kristiangoystdal/Design-av-Integrerte-Kretser---Prosjekt/main.tex

\documentclass{article}
\usepackage{graphicx} % Required for inserting images
\usepackage{svg} % Makes it possible to include svg-images
\usepackage{cite}
\usepackage[a4paper, total={6in, 8in}]{geometry}
\usepackage{float}
\usepackage{makecell}
\usepackage{colortbl}
\usepackage{listings}
\usepackage[colorlinks=true,allcolors=black]{hyperref}
\usepackage[british]{babel}     % Defining UK English as language. This will among other things ensure that dates are displayed as 24/03/1997 rather than 03/24/1997 in the bibliography.
\addto\extrasbritish{   % Change naming of different functions, e.g. figure references.
    \renewcommand*\contentsname{Table of Contents}  % Rename table of contents
    \renewcommand{\listfigurename}{List of Figures} % Rename list of figures
    \renewcommand{\listtablename}{List of Tables}   % Rename list of tables
    \def\equationautorefname{Equation}              % Autoref-name for equations
    \def\figureautorefname{Figure}                  % Autoref-name for figures
    \def\tableautorefname{Table}                    % Autoref-name for tables
    \def\sectionautorefname{Section}                % Autoref-name for sections
    \def\subsectionautorefname{Subsection} % Autoref-name for subsections
    \def\subsubsectionautorefname{Subsection} % Autoref-name for subsubsections
    \def\appendixautorefname{Appendix}
}

\usepackage{appendix}
\usepackage{lipsum}
\usepackage{geometry}

% begin appendix autoref patch [\autoref subsections in appendix](https://tex.stackexchange.com/questions/149807/autoref-subsections-in-appendix)
\usepackage{etoolbox}
\makeatletter
\patchcmd{\hyper@makecurrent}{%
    \ifx\Hy@param\Hy@chapterstring
        \let\Hy@param\Hy@chapapp
    \fi
}{%
    \iftoggle{inappendix}{%true-branch
        % list the names of all sectioning counters here
        \@checkappendixparam{chapter}%
        \@checkappendixparam{section}%
        \@checkappendixparam{subsection}%
        \@checkappendixparam{subsubsection}%
        \@checkappendixparam{paragraph}%
        \@checkappendixparam{subparagraph}%
    }{}%
}{}{\errmessage{failed to patch}}

\newcommand*{\@checkappendixparam}[1]{%
    \def\@checkappendixparamtmp{#1}%
    \ifx\Hy@param\@checkappendixparamtmp
        \let\Hy@param\Hy@appendixstring
    \fi
}
\makeatletter

\newtoggle{inappendix}
\togglefalse{inappendix}

\apptocmd{\appendix}{\toggletrue{inappendix}}{}{\errmessage{failed to patch}}
\apptocmd{\subappendices}{\toggletrue{inappendix}}{}{\errmessage{failed to patch}}
% end appendix autoref patch

\lstdefinestyle{aimspiceStyle}{
    language=Verilog,
    basicstyle=\small\ttfamily,
    commentstyle=\color{red}, % Adjust the color as needed
    morecomment=[l]{*}, % Define '*' as the comment character
    keywordstyle=,
    numberstyle=\tiny\color{gray},
    numbers=left,
    numbersep=5pt,
    breaklines=true,
    frame=lines,
    backgroundcolor=\color{lightgray!20},
}

\definecolor{codegreen}{rgb}{0,0.6,0}
\definecolor{codegray}{rgb}{0.5,0.5,0.5}
\definecolor{codepurple}{rgb}{0.58,0,0.82}
\definecolor{backcolour}{rgb}{0.95,0.95,0.92}

\lstdefinestyle{outputstyle}{
    language=Verilog,
    backgroundcolor=\color{backcolour},
    commentstyle=\color{codegreen},
    keywordstyle=\color{black},
    numberstyle=\tiny\color{codegray},
    stringstyle=\color{codepurple},
    basicstyle=\footnotesize\ttfamily,
    breakatwhitespace=false,
    breaklines=true,
    captionpos=b,
    frame=single, % Add this line to draw a frame around the code
    numbers=none, % Set this to none to disable line numbering
    keepspaces=true,
    showspaces=false,
    showstringspaces=false,
    showtabs=false,
    tabsize=2
}

\lstset{style=outputstyle}

\lstdefinestyle{verilogStyle}{
    language=Verilog,     % Set the language to Verilog
    basicstyle=\small\ttfamily,
    commentstyle=\color{red},
    keywordstyle=\color{blue},
    numberstyle=\tiny\color{gray},
    numbers=left,
    numbersep=5pt,
    breaklines=true,
    frame=lines,
    backgroundcolor=\color{lightgray!20}, % Lighter background color
}
\usepackage{titlesec}

\setcounter{secnumdepth}{4}
\titleformat{\paragraph}
{\normalfont\normalsize\bfseries}{\theparagraph}{1em}{}
\titlespacing*{\paragraph}
{0pt}{3.25ex plus 1ex minus .2ex}{1.5ex plus .2ex}

\newcommand{\HRule}{\rule{\linewidth}{0.5mm}}

\begin{document}

\begin{titlepage}
\vbox{ }
\vbox{ }
\begin{center}
% Upper part of the page
\includesvg[width=\textwidth]{Figures/logo.svg}\\[1cm]
\textsc{\LARGE TFE4152 Design of Integrated Circuits}\\[1cm]
\textsc{\Large Term project fall 2023}\\[0.5cm]
\vbox{ }

% Title
\HRule \\[0.4cm]
{ \huge \bfseries Design \& Test of a \\Multiply-Accumulate unit}\\[0.4cm] %TODO: replace "TITLE" with some project title, e.g. "Design of a Multiply Accumulate Unit"
\HRule \\[1.5cm]

% Author
\large
\emph{Authors:}\\
Einar Bergslid \& Kristian Gøystdal %TODO: Replace this line with your names
\vfill

\end{center}
\end{titlepage}

\newpage
\setlength{\parskip}{0ex}
\renewcommand{\baselinestretch}{0.1}\normalsize
\tableofcontents
\renewcommand{\baselinestretch}{1.00}\normalsize
\setlength{\parskip}{2ex}
\rule{\textwidth}{1pt}
\newpage

\input{Text/Introduction}
\input{Text/Theory}
\input{Text/Method}
\input{Text/Results}
\input{Text/Discussion}
\input{Text/Conclusion}

\newpage
\addcontentsline{toc}{section}{References}
\bibliographystyle{unsrt}
\bibliography{bibliography}

\newpage
\vspace*{7 cm}
\begin{center}
\textbf{\Huge Appendices}
\end{center}
\addcontentsline{toc}{section}{Appendices}
\include{Text/appendix.tex}
\end{document}
