kristiangoystdal/Design-av-Integrerte-Kretser---Prosjekt/Figures/1-bit register.png

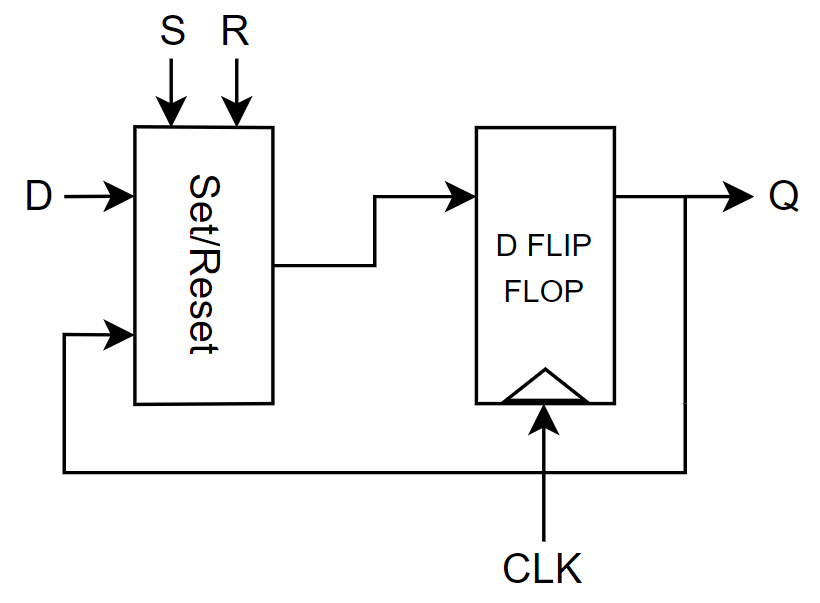
Figures/1-bit register.png
