kristiangoystdal/Design-av-Integrerte-Kretser---Prosjekt/Figures/8bitadder.png

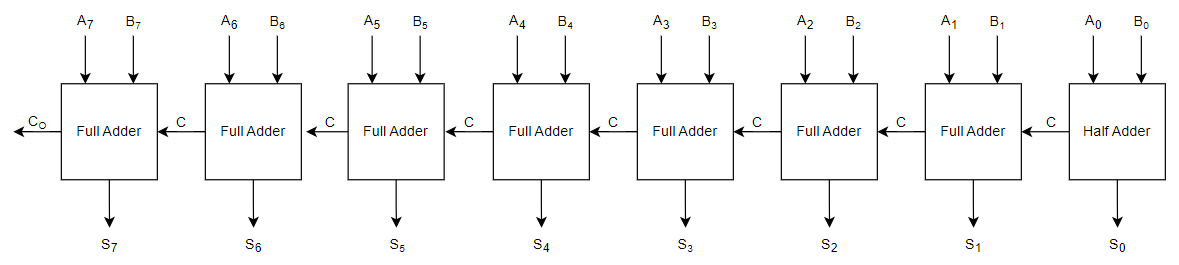
Figures/8bitadder.png
