kristiangoystdal/Design-av-Integrerte-Kretser---Prosjekt/Figures/8bitRegister.png

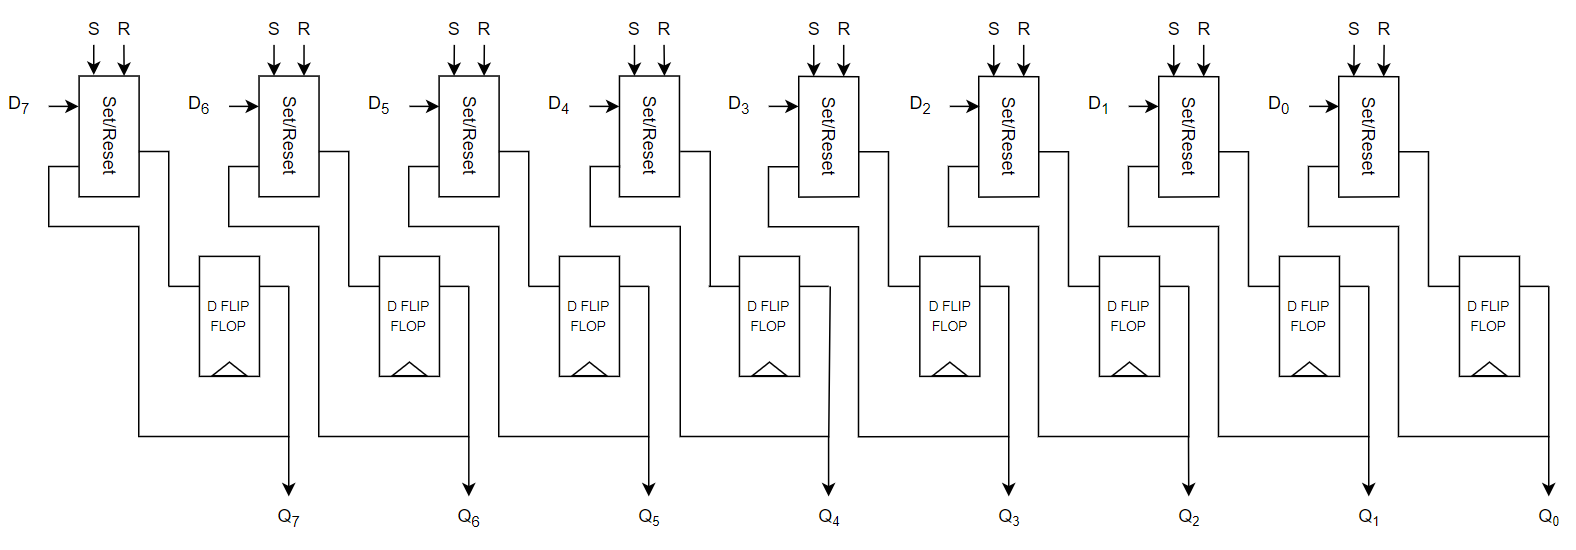
Figures/8bitRegister.png
