kristiangoystdal/Design-av-Integrerte-Kretser---Prosjekt/Figures/Aimspice_Plots/CornerFF.png

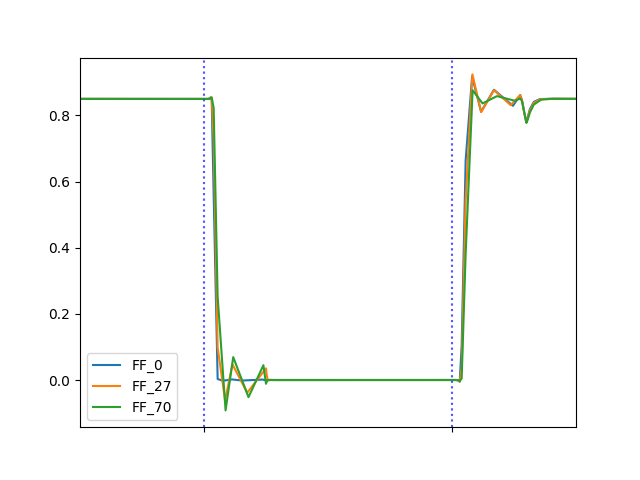
Figures/Aimspice_Plots/CornerFF.png
