kristiangoystdal/Design-av-Integrerte-Kretser---Prosjekt/Figures/Aimspice_Plots/FF_0.png

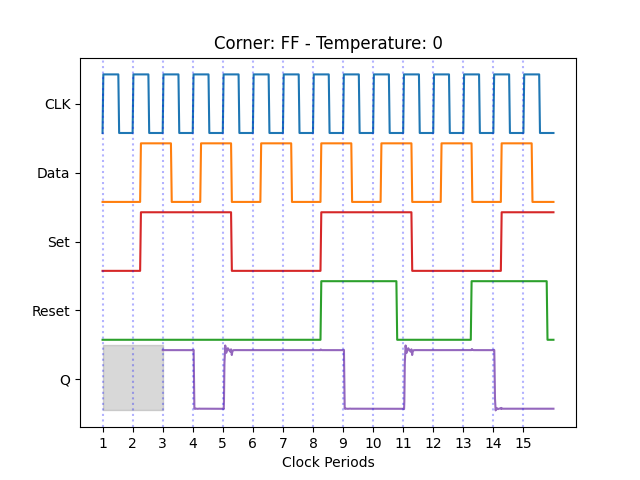
Figures/Aimspice_Plots/FF_0.png
