kristiangoystdal/Design-av-Integrerte-Kretser---Prosjekt/Figures/Aimspice_Plots/FF_27.png

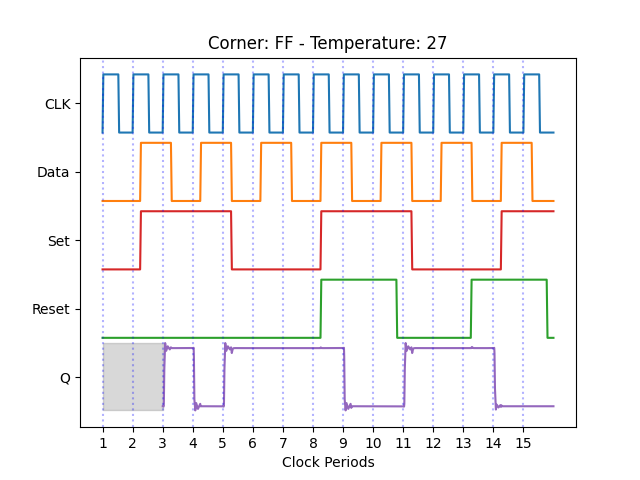
Figures/Aimspice_Plots/FF_27.png
