kristiangoystdal/Design-av-Integrerte-Kretser---Prosjekt/Figures/Aimspice_Plots/FS_27.png

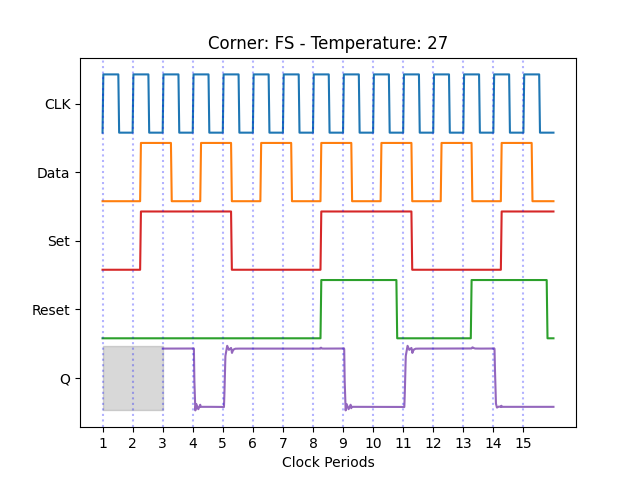
Figures/Aimspice_Plots/FS_27.png
