kristiangoystdal/Design-av-Integrerte-Kretser---Prosjekt/Figures/Aimspice_Plots/Temperatur70.png

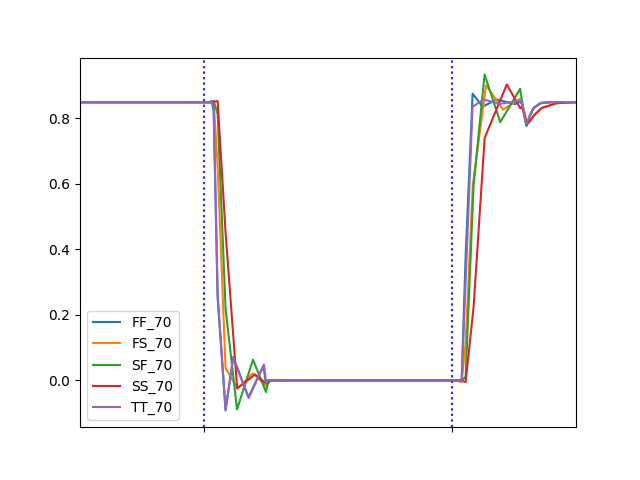
Figures/Aimspice_Plots/Temperatur70.png
