kristiangoystdal/Design-av-Integrerte-Kretser---Prosjekt/Figures/And gate.png

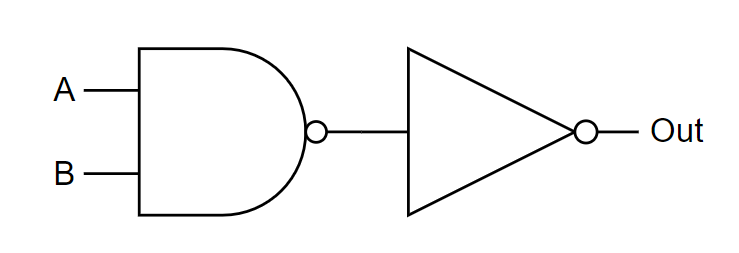
Figures/And gate.png
