kristiangoystdal/Design-av-Integrerte-Kretser---Prosjekt/Figures/Blokk.png

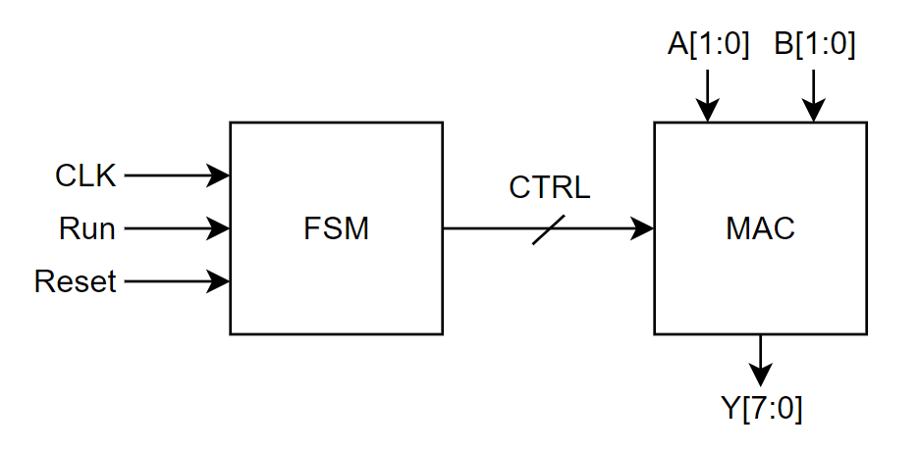
Figures/Blokk.png
