kristiangoystdal/Design-av-Integrerte-Kretser---Prosjekt/Figures/CornersTheory.png

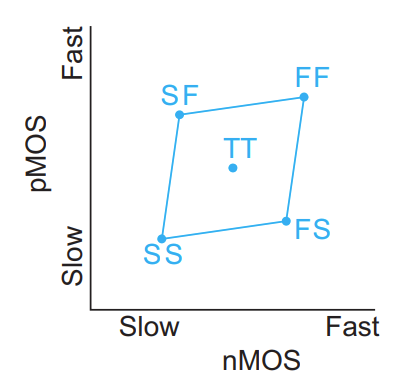
Figures/CornersTheory.png
