kristiangoystdal/Design-av-Integrerte-Kretser---Prosjekt/Figures/Current_VDD_FF.png

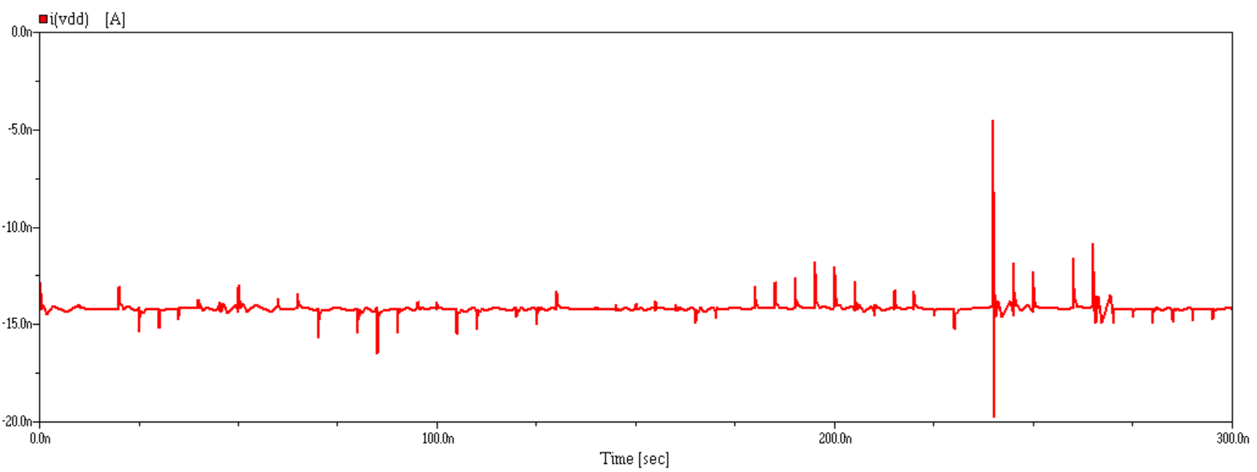
Figures/Current_VDD_FF.png
