kristiangoystdal/Design-av-Integrerte-Kretser---Prosjekt/Figures/Current_VDD_TT.png

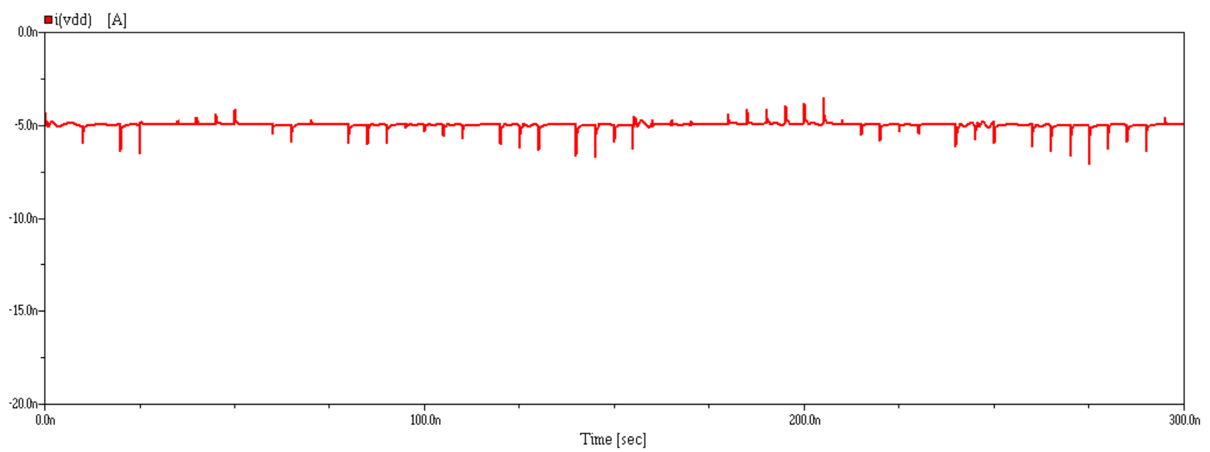
Figures/Current_VDD_TT.png
