kristiangoystdal/Design-av-Integrerte-Kretser---Prosjekt/Figures/D_Flip_Flop.png

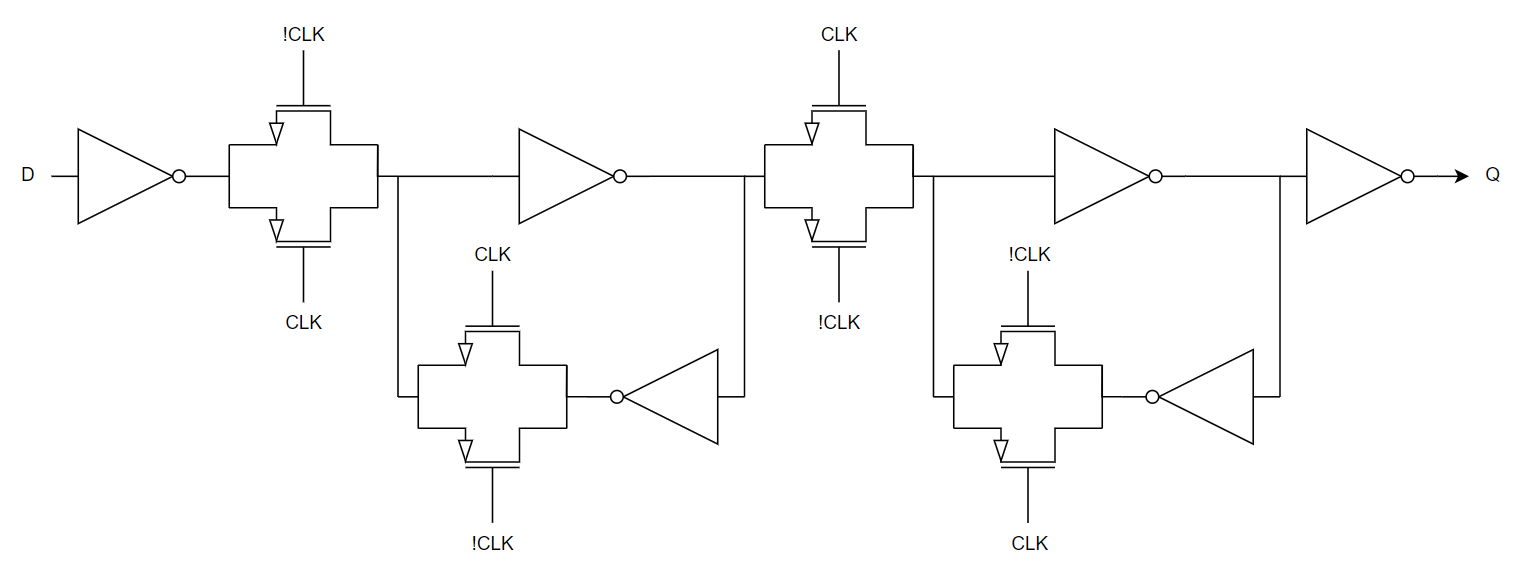
Figures/D_Flip_Flop.png
