kristiangoystdal/Design-av-Integrerte-Kretser---Prosjekt/Figures/DFF_Block.png

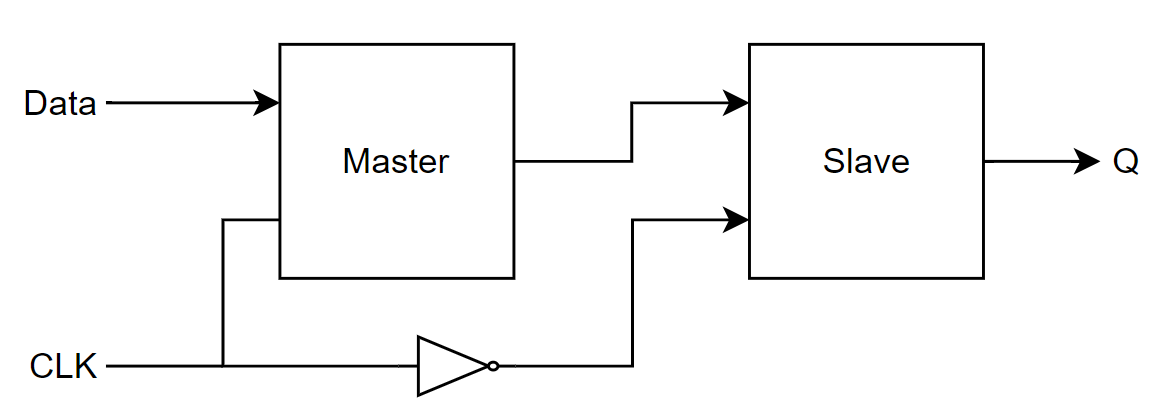
Figures/DFF_Block.png
