kristiangoystdal/Design-av-Integrerte-Kretser---Prosjekt/Figures/FSM LOGIC.drawio.png

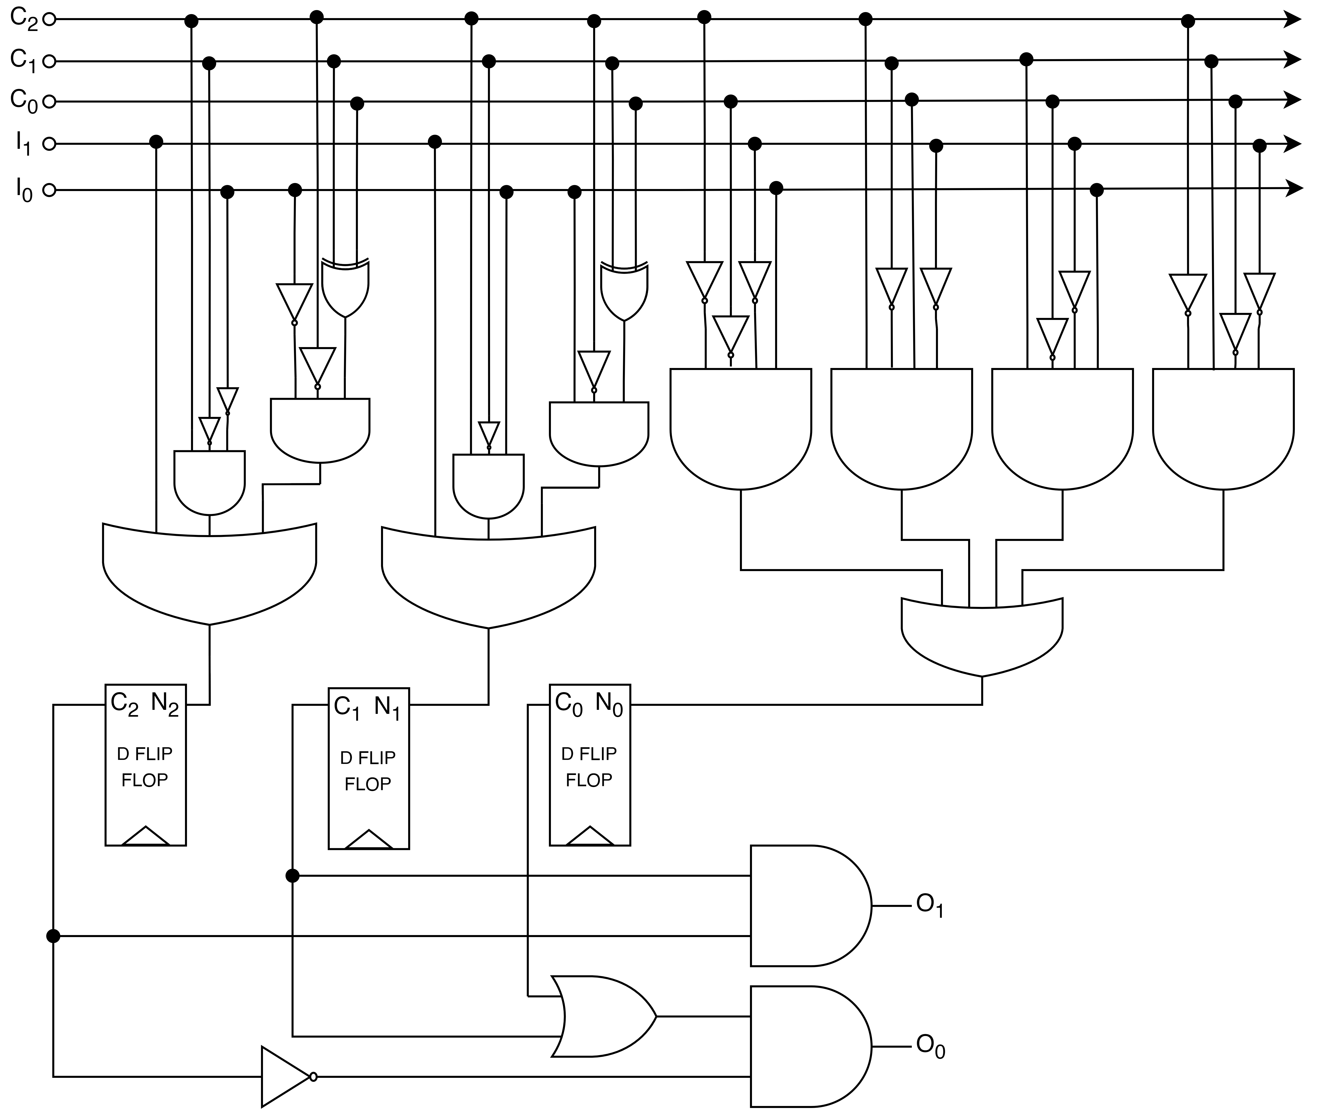
Figures/FSM LOGIC.drawio.png
