kristiangoystdal/Design-av-Integrerte-Kretser---Prosjekt/Figures/FSM-diagram.png

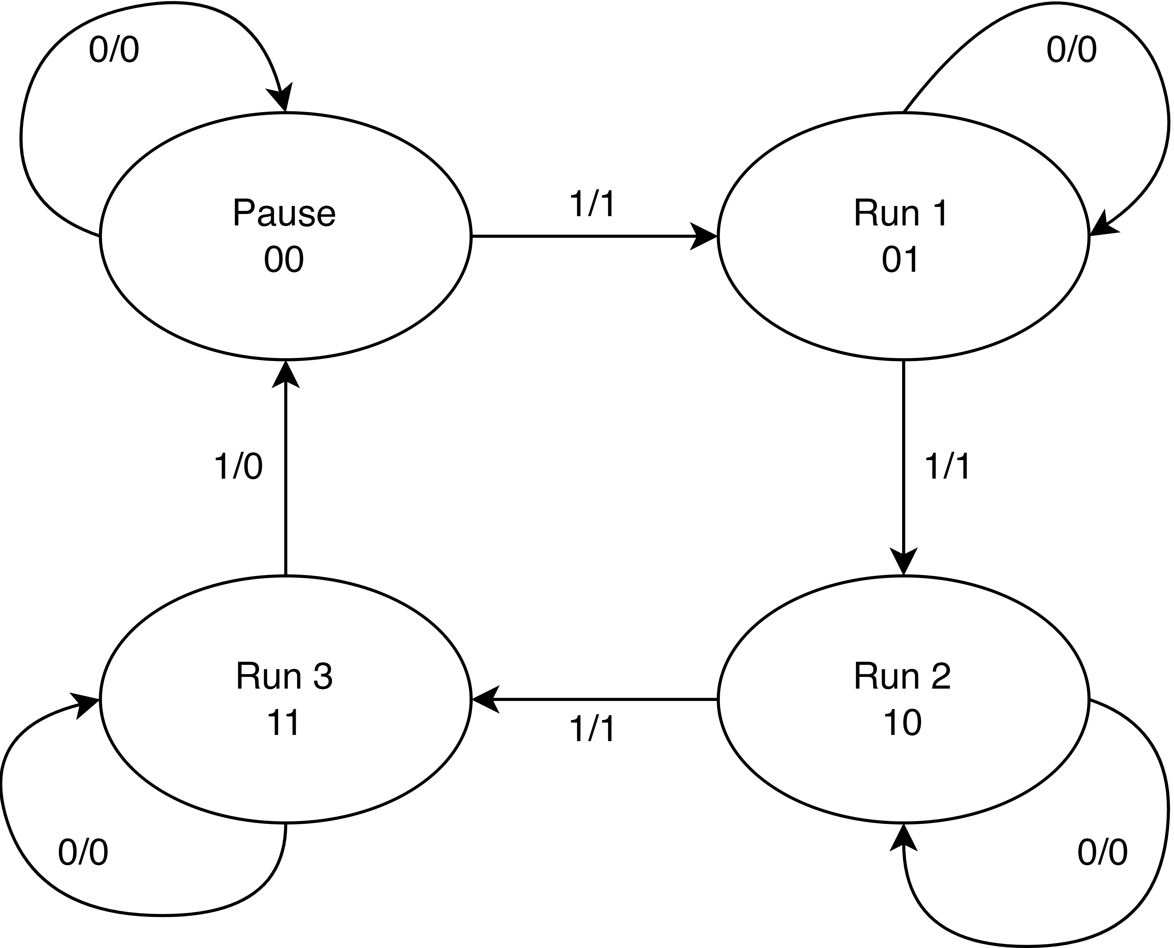
Figures/FSM-diagram.png
