kristiangoystdal/Design-av-Integrerte-Kretser---Prosjekt/Figures/FSM_overordnet.drawio.png

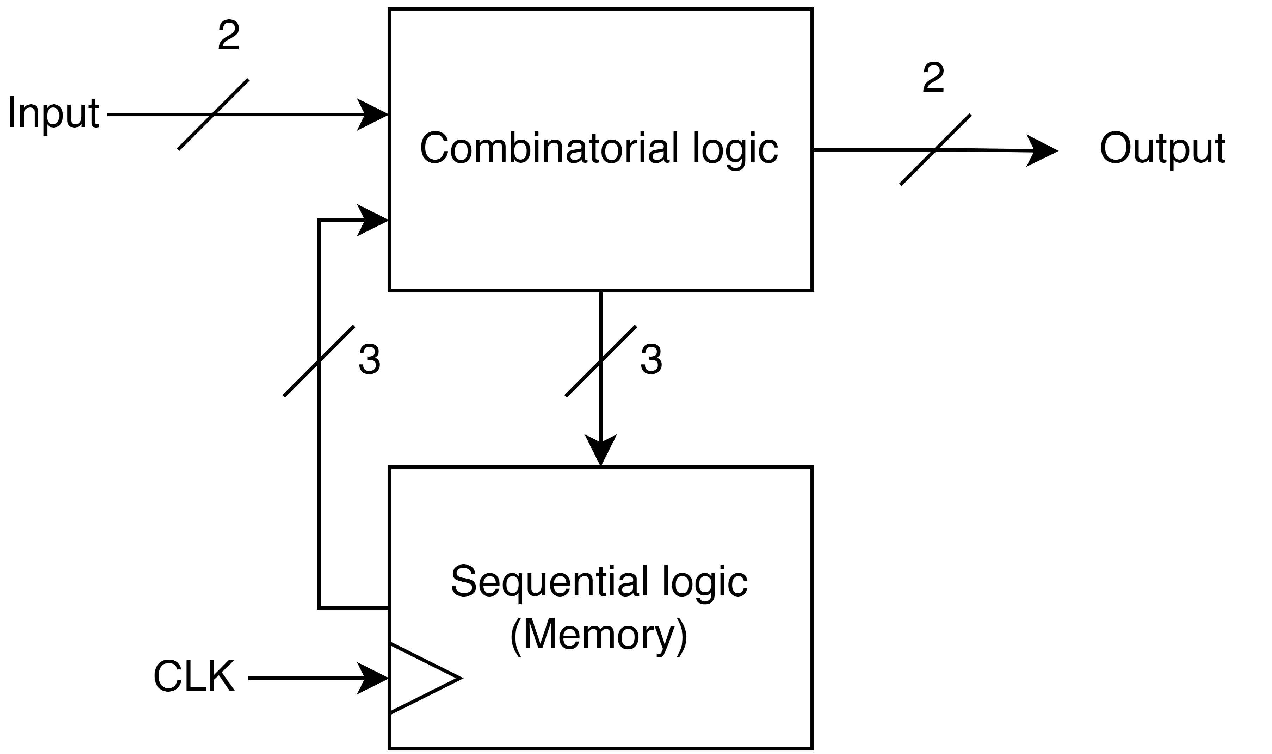
Figures/FSM_overordnet.drawio.png
