kristiangoystdal/Design-av-Integrerte-Kretser---Prosjekt/Figures/fulladder.png

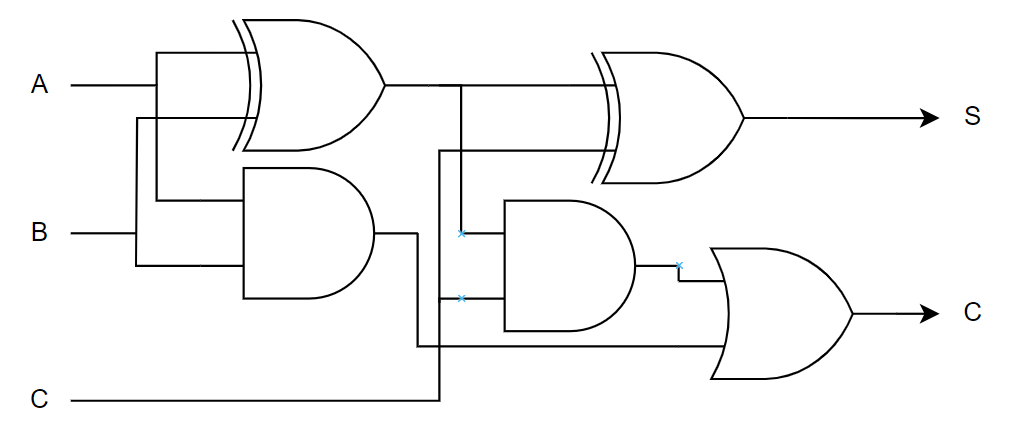
Figures/fulladder.png
