kristiangoystdal/Design-av-Integrerte-Kretser---Prosjekt/Figures/general fsm diagrams.png

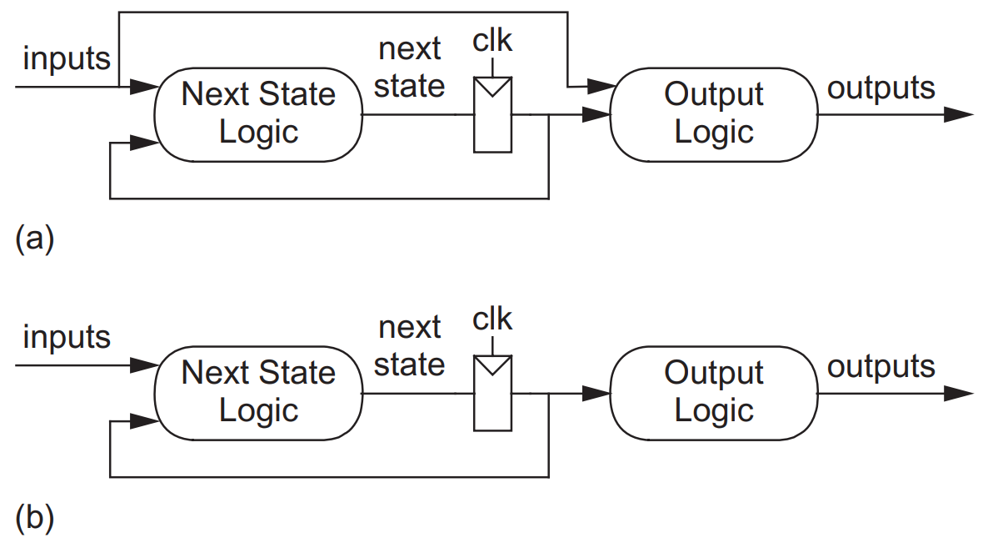
Figures/general fsm diagrams.png
