kristiangoystdal/Design-av-Integrerte-Kretser---Prosjekt/Figures/halfadder.png

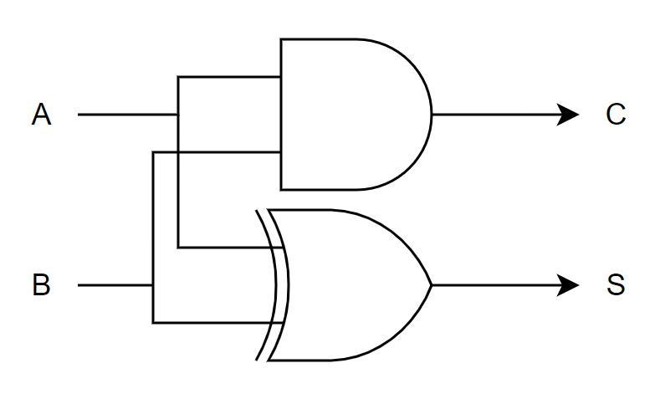
Figures/halfadder.png
