kristiangoystdal/Design-av-Integrerte-Kretser---Prosjekt/Figures/Leakage_current_ratios.png

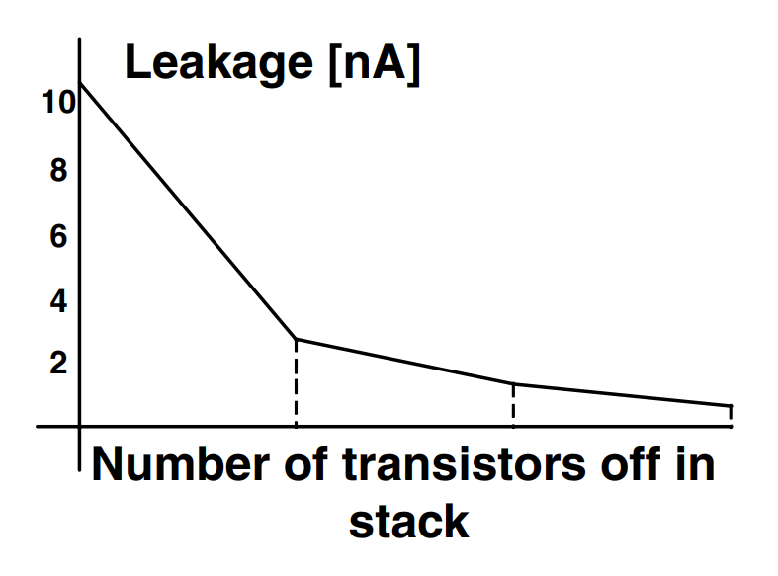
Figures/Leakage_current_ratios.png
