kristiangoystdal/Design-av-Integrerte-Kretser---Prosjekt/Figures/logic diagram.png

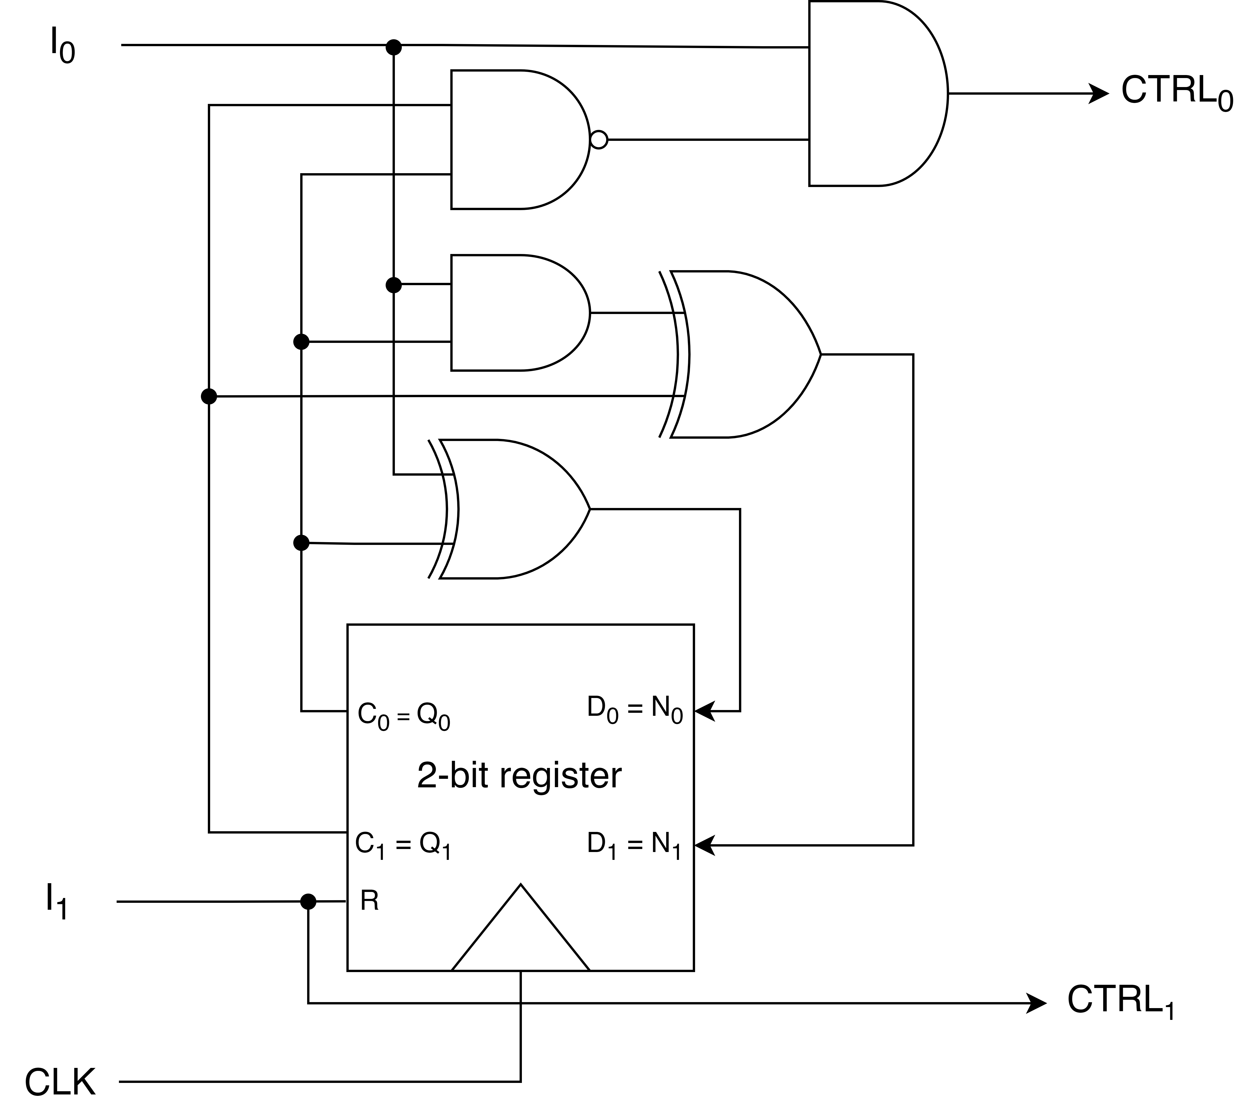
Figures/logic diagram.png
