kristiangoystdal/Design-av-Integrerte-Kretser---Prosjekt/Figures/mac-blokk.png

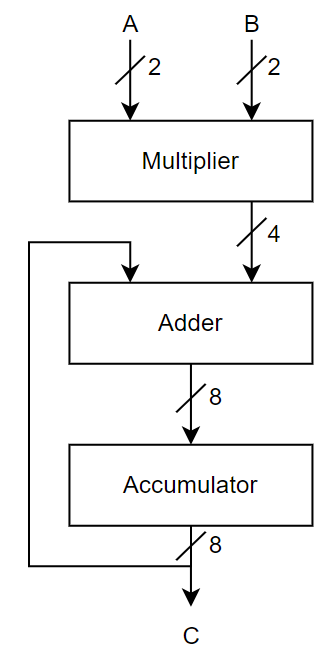
Figures/mac-blokk.png
