kristiangoystdal/Design-av-Integrerte-Kretser---Prosjekt/Figures/multiplier.png

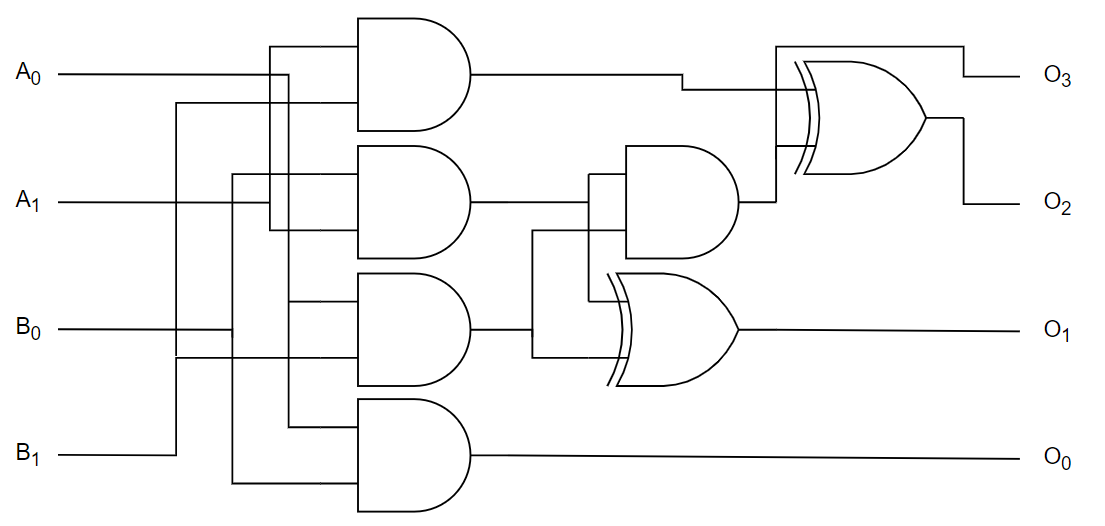
Figures/multiplier.png
