kristiangoystdal/Design-av-Integrerte-Kretser---Prosjekt/Figures/Nand Gate.png

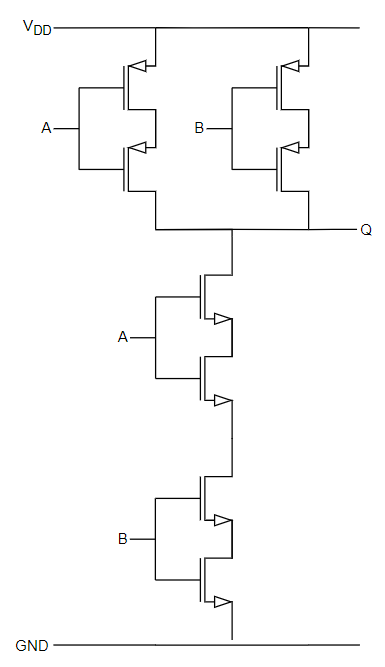
Figures/Nand Gate.png
