kristiangoystdal/Design-av-Integrerte-Kretser---Prosjekt/Figures/Nor gate.png

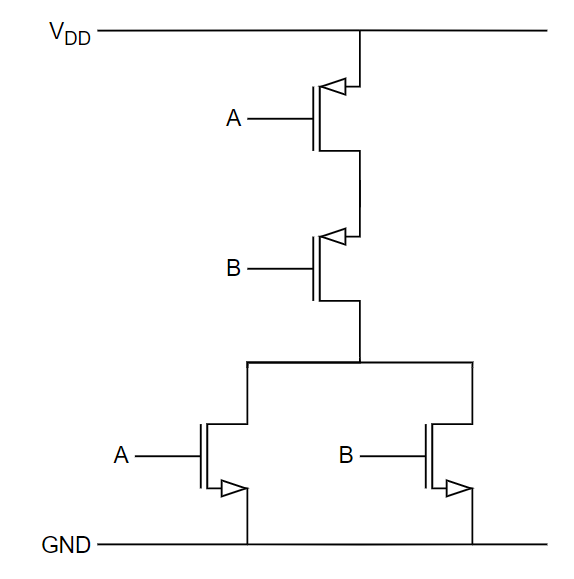
Figures/Nor gate.png
