kristiangoystdal/Design-av-Integrerte-Kretser---Prosjekt/Figures/Not gate.png

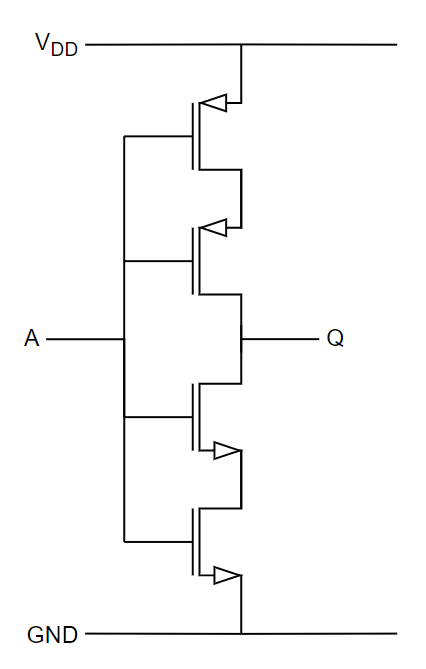
Figures/Not gate.png
