kristiangoystdal/Design-av-Integrerte-Kretser---Prosjekt/Figures/Pull_UP_DOWN.png

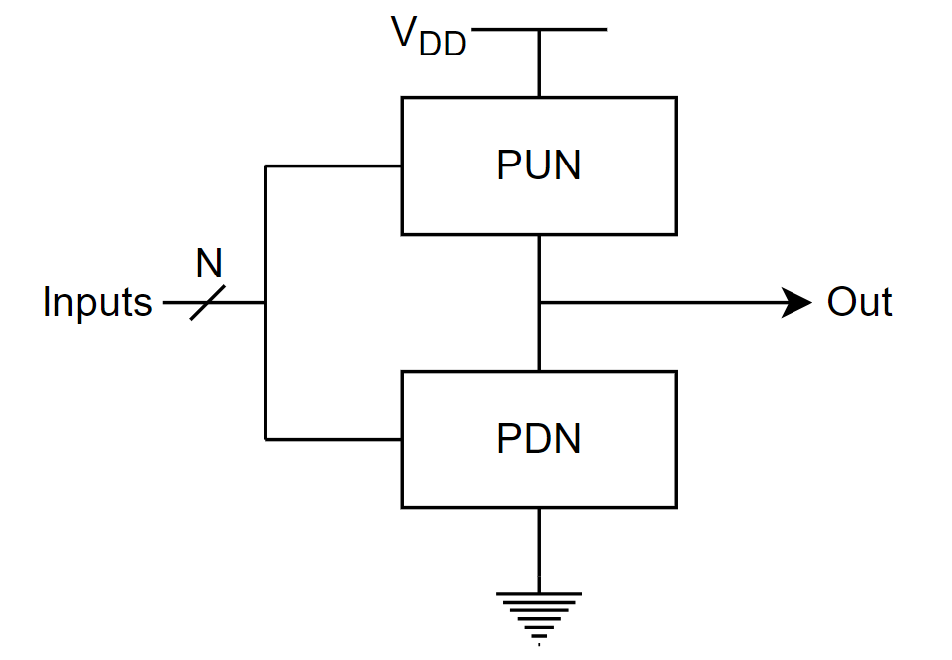
Figures/Pull_UP_DOWN.png
