kristiangoystdal/Design-av-Integrerte-Kretser---Prosjekt/Figures/setReset.png

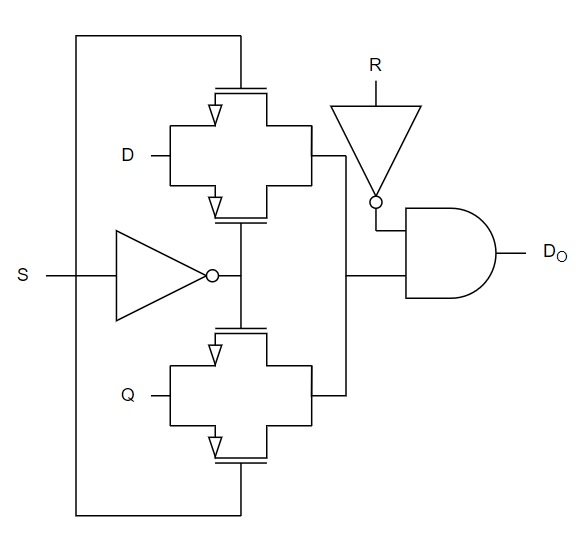
Figures/setReset.png
