kristiangoystdal/Design-av-Integrerte-Kretser---Prosjekt/Figures/Transistor Stacking.png

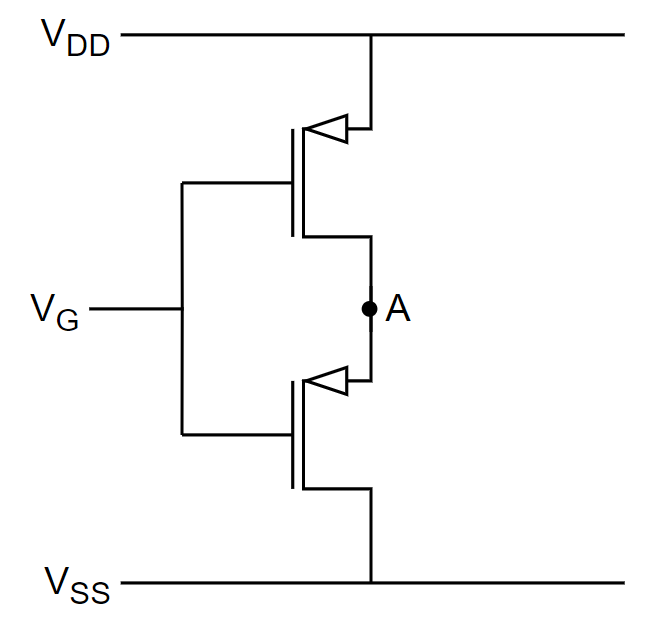
Figures/Transistor Stacking.png
