kristiangoystdal/Design-av-Integrerte-Kretser---Prosjekt/Figures/Transmission gate.png

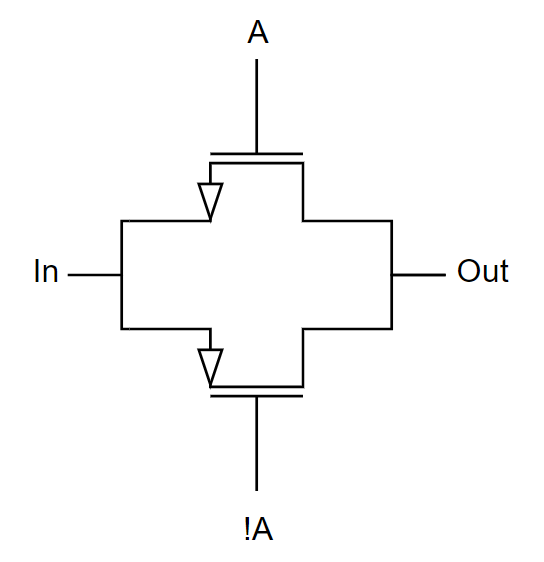
Figures/Transmission gate.png
