kristiangoystdal/Design-av-Integrerte-Kretser---Prosjekt/Figures/FSM_testbench_out.png

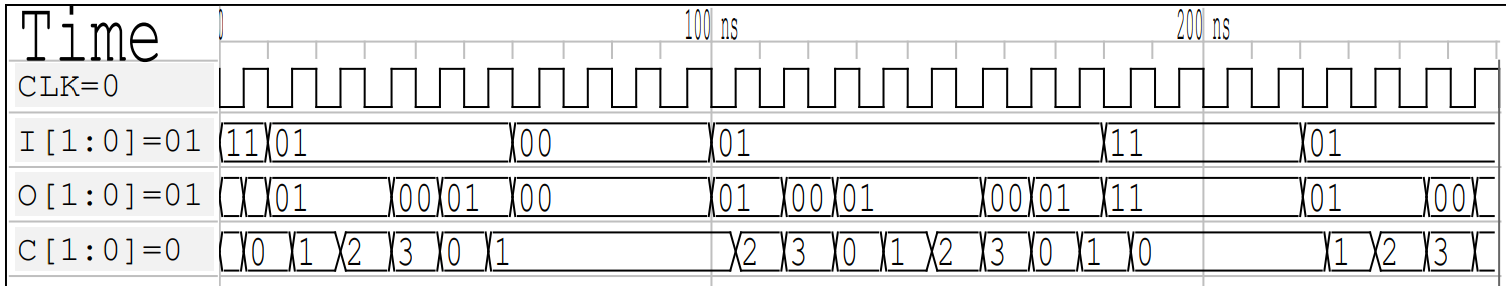
Figures/FSM_testbench_out.png
