kristiangoystdal/Design-av-Integrerte-Kretser---Prosjekt/Figures/Result full MAC3.png

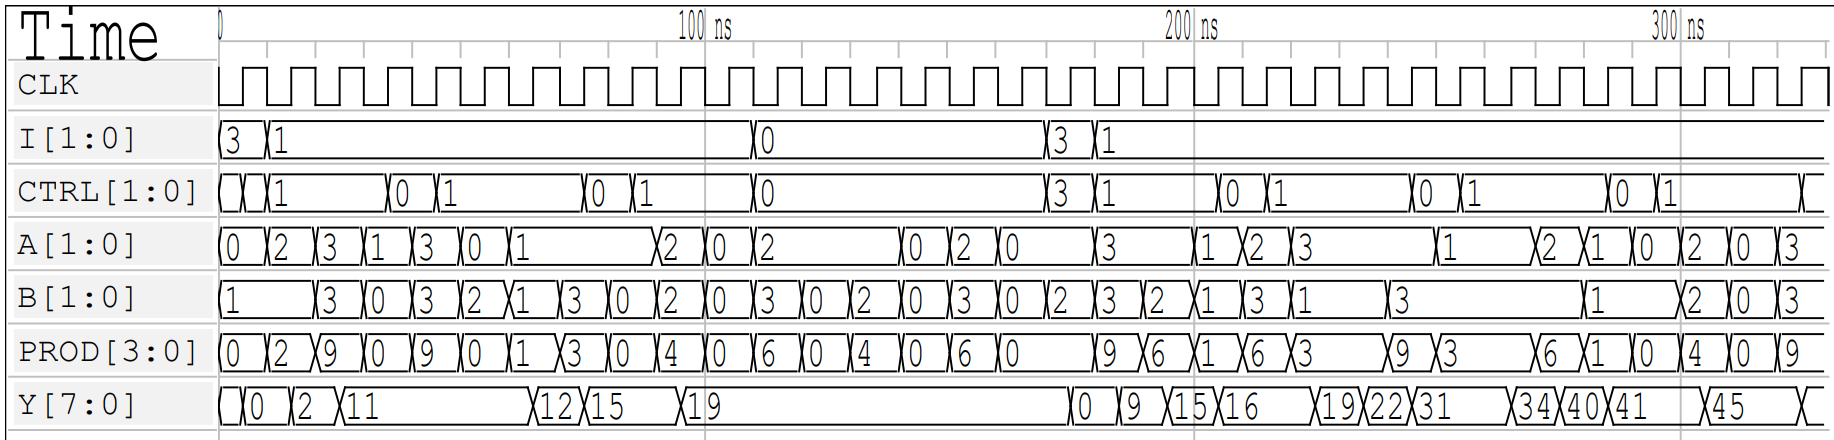
Figures/Result full MAC3.png
