kristiangoystdal/Design-av-Integrerte-Kretser---Prosjekt/Figures/Result MAC.png

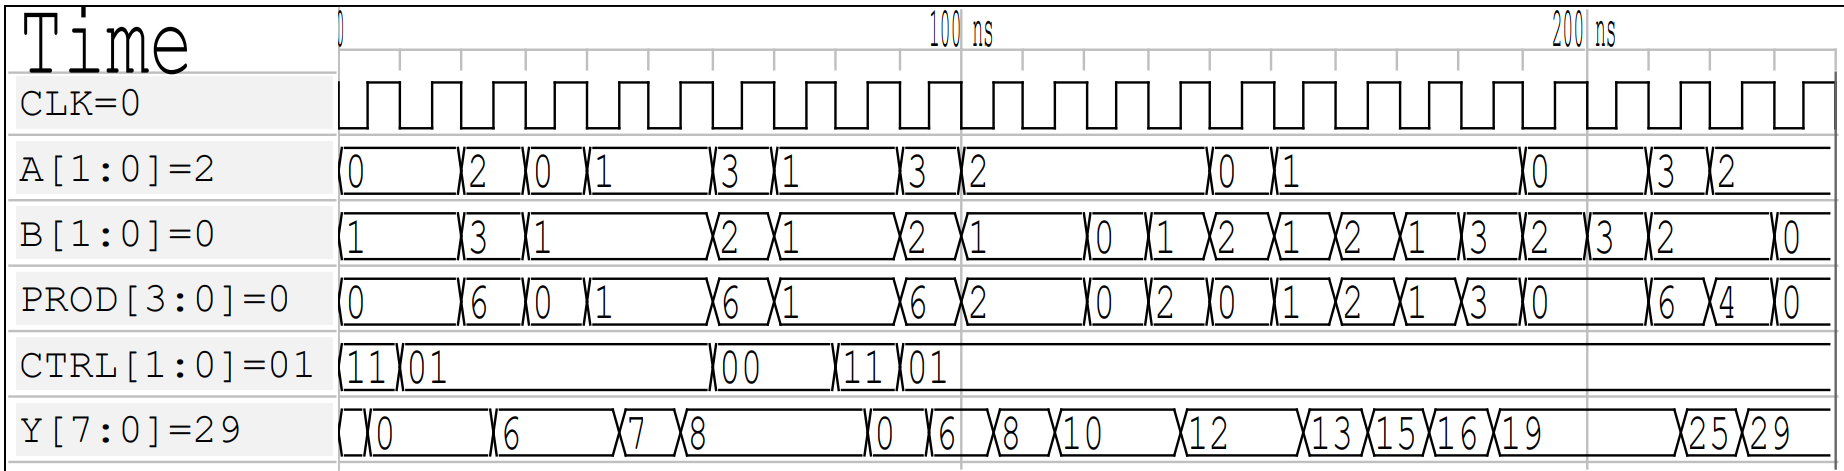
Figures/Result MAC.png
