kristiangoystdal/Design-av-Integrerte-Kretser---Prosjekt/Figures/Test of FSM.png

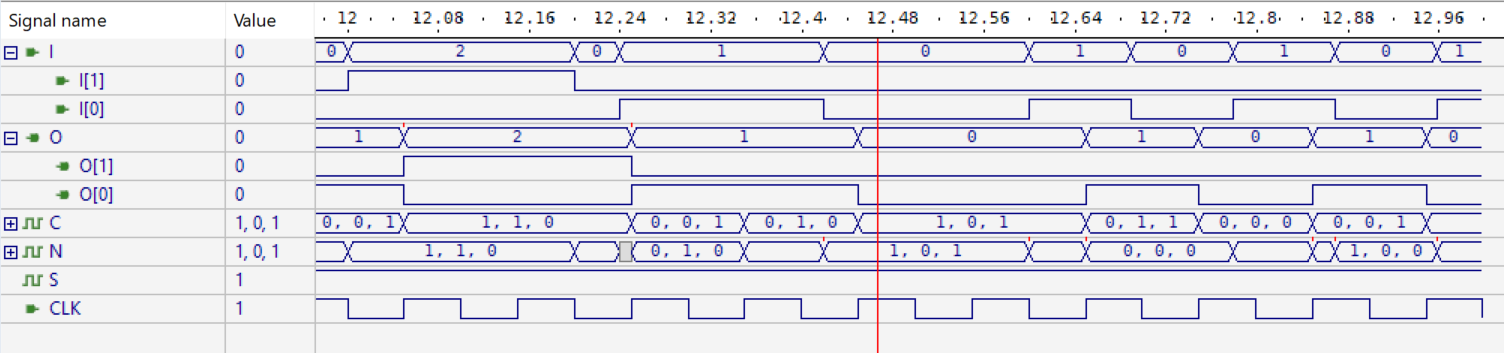
Figures/Test of FSM.png
