kristiangoystdal/Design-av-Integrerte-Kretser---Prosjekt/(commit log)

2023-10-24 csv files
    [ff0.csv, ff27.csv, ff70.csv, fs0.csv, fs27.csv, fs70.csv, sf0.csv, sf27.csv]
2023-10-24 Updates from Overleaf
    [ff0.csv, ff27.csv, ff70.csv, fs0.csv, fs27.csv, fs70.csv, sf0.csv, sf27.csv]
2023-10-24 images of current
2023-10-24 Verilog Project
    [compile.cfg, library.cfg, projlib.cfg]
2023-10-25 switched from assign to wire for the inverters
2023-11-15 leakage current in inverter
2023-11-17 updated csv file for 100n width
    [ff_0.csv, ff_27.csv, ff_70.csv, fs_0.csv, fs_27.csv, fs_70.csv, sf_0.csv, sf_27.csv]
2023-11-20 FIgures comparing all corners and temperatures
2023-11-20 leakage current ratio figure
2023-11-22 New verilog files
    [compile.cfg, library.cfg, projlib.cfg]
